bharrisau/spacer_board/README.md

spacer_board
=======

Double sided PCB shim to enable stencil8 style assembly without panelising or modifying target board. Combined effort with [nice technology](https://nicegear.co.nz/).

Eagle style repository - https://github.com/hadleyrich/Stencil-Helper

##Update
There are two hole layouts - the 0.1 version has the far right hand column as 5,9,4,0. The newer layout is 8,4,6,2. The newer layout optimises the locations of the pins when in use, and also adds a diagonal slot in the corner.

0.1 edition boards available through nice technology - http://nicegear.co/stencil-helper

##Licence
This work is licensed under the [Creative Commons Attribution 3.0 Unported License](http://creativecommons.org/licenses/by/3.0/). Full text of license is available in LICENSE.
