bharrisau/spacer_board/(commit log)

2013-06-30 Improved layout, increased hole size
    [SpacerBoard-B_Cu.gbl, SpacerBoard-B_Mask.gbs, SpacerBoard-B_SilkS.gbo, SpacerBoard-Edge_Cuts.gbr, SpacerBoard-F_Cu.gtl, SpacerBoard-F_Mask.gts, SpacerBoard-F_SilkS.gto, SpacerBoard-NPTH.drl]
2013-07-01 File changes
    [SpacerBoard.kicad_pcb]
2013-07-14 Added corner slot. Changed silk to copper-under-mask
    [SpacerBoard-B_Cu.gbl, SpacerBoard-B_Mask.gbs, SpacerBoard-B_SilkS.gbo, SpacerBoard-Edge_Cuts.gbr, SpacerBoard-F_Cu.gtl, SpacerBoard-F_Mask.gts, SpacerBoard-F_SilkS.gto, SpacerBoard-NPTH.drl]
